AndrewWash/Ottopot_buttons/ottopotSC/assets/0.9-ottopot-glamour.jpeg

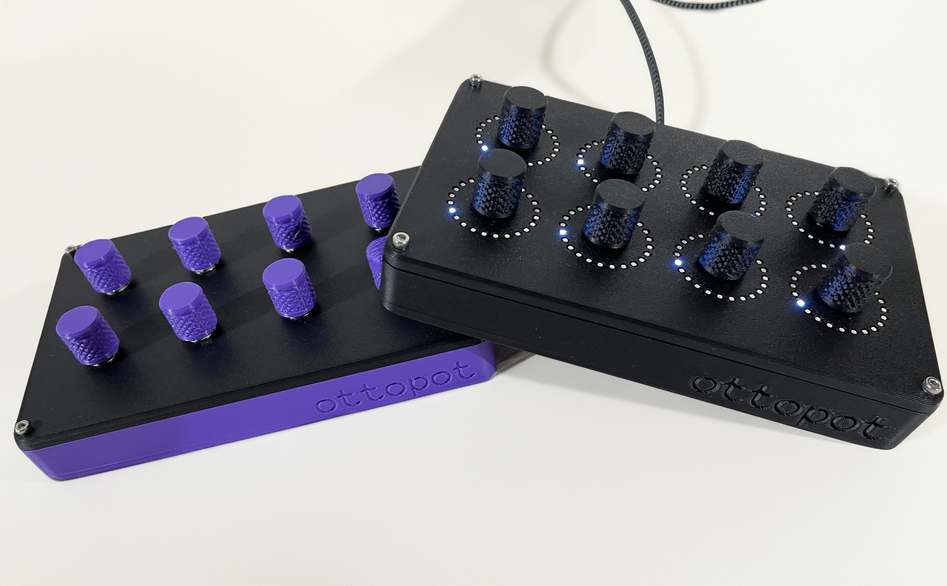
ottopotSC/assets/0.9-ottopot-glamour.jpeg
