AndrewWash/Ottopot_buttons/ottopotSC/assets/ottopot-glamour.jpeg

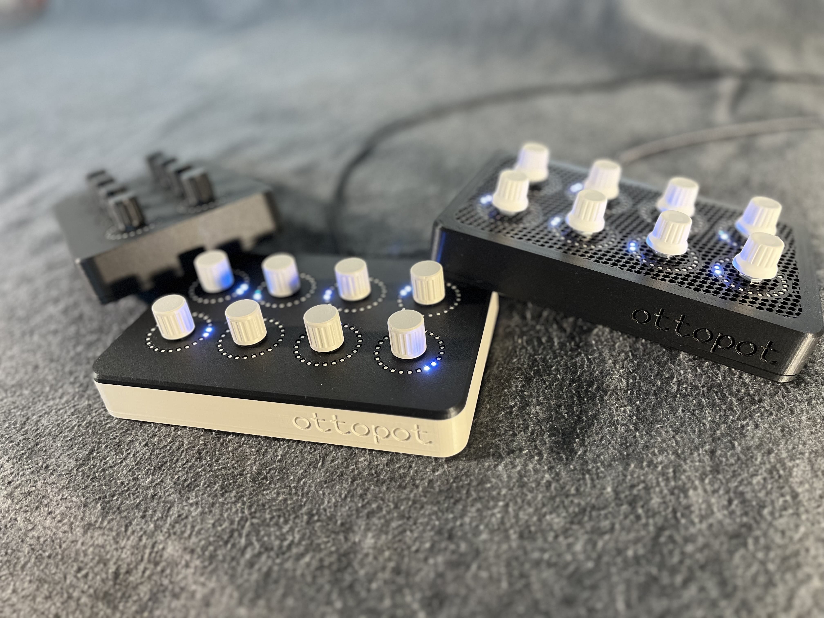
ottopotSC/assets/ottopot-glamour.jpeg
