AndrewWash/Ottopot_buttons/(list of files, cad)

Other CAD files:
ottopotSC/3D Models/Ottopot_v5-Knob.blend
ottopotSC/3D Models/Ottopot_v5.blend
zArchive/ottopotSC/3D Models/Ottopot_v5-Knob.blend
zArchive/ottopotSC/3D Models/Ottopot_v5.blend
