AndrewWash/Ottopot_buttons/ottopotSC/kicad/Ottopot.kicad_pcb

## KiCad design zArchive/ottopotSC/kicad/Ottopot.kicad_pcb (2026-05-15, an earlier design)

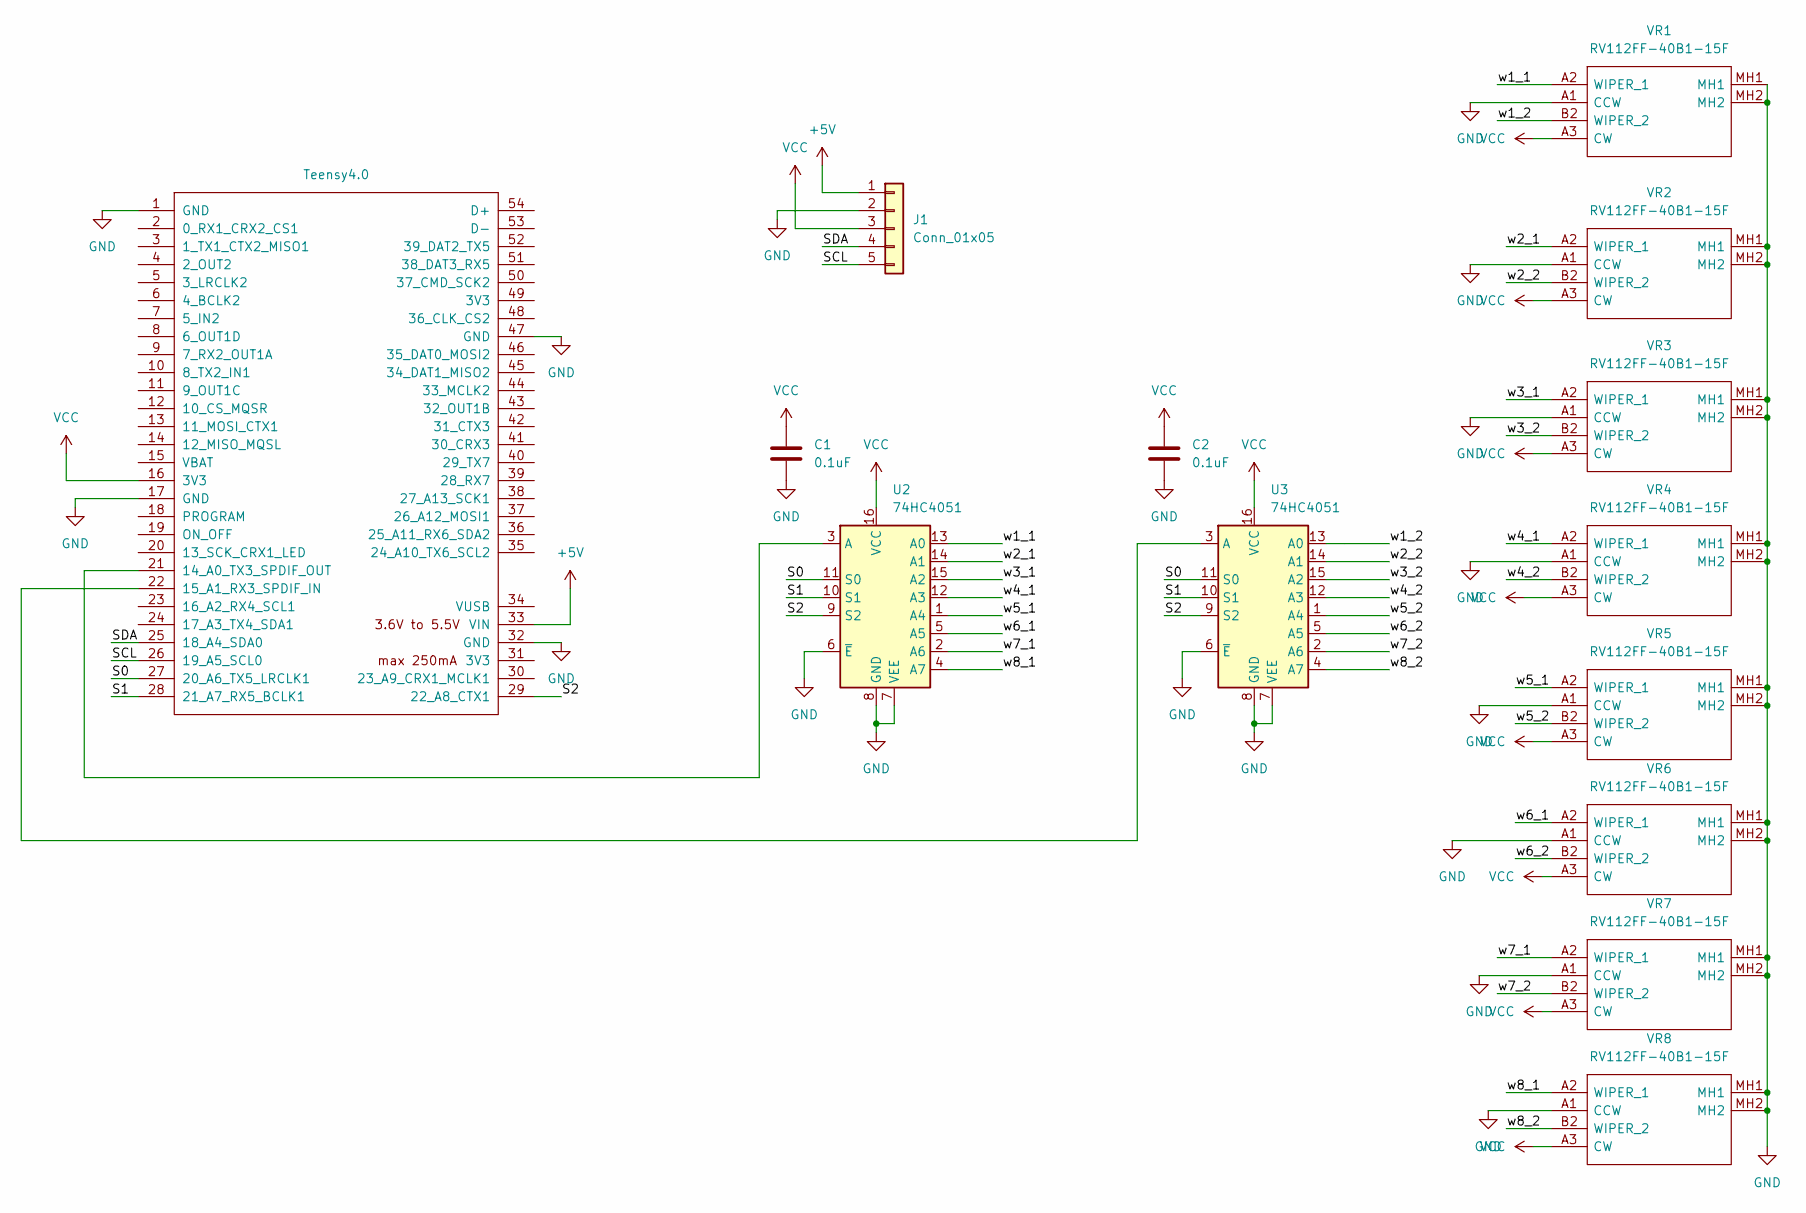
[picture p3: schematic Ottopot.kicad_sch]

Parts:
C1, C2: 0.1uF; C_Disc_D3.0mm_W1.6mm_P2.50mm
J1: Conn_01x05; Molex_PicoBlade_53048-0510_1x05_P1.25mm_Horizontal
U1: Teensy4.0; Teensy40
U2, U3: 74HC4051; DIP-16_W7.62mm
VR1, VR2, VR3, VR4, VR5, VR6, VR7, VR8: RV112FF-40B1-15F; RV112FF40B115F; Manufacturer_Part_Number RV112FF-40B1-15F

Connections:
+5V: J1.1, U1.33 (VIN)
/S0: U1.27 (20_A6_TX5_LRCLK1), U2.11 (S0), U3.11 (S0)
/S1: U1.28 (21_A7_RX5_BCLK1), U2.10 (S1), U3.10 (S1)
/S2: U1.29 (22_A8_CTX1), U2.9 (S2), U3.9 (S2)
/SCL: J1.5, U1.26 (19_A5_SCL0)
/SDA: J1.4, U1.25 (18_A4_SDA0)
/w1_1: U2.13 (A0), VR1.A2 (WIPER_1)
/w1_2: U3.13 (A0), VR1.B2 (WIPER_2)
/w2_1: U2.14 (A1), VR2.A2 (WIPER_1)
/w2_2: U3.14 (A1), VR2.B2 (WIPER_2)
/w3_1: U2.15 (A2), VR3.A2 (WIPER_1)
/w3_2: U3.15 (A2), VR3.B2 (WIPER_2)
/w4_1: U2.12 (A3), VR4.A2 (WIPER_1)
/w4_2: U3.12 (A3), VR4.B2 (WIPER_2)
/w5_1: U2.1 (A4), VR5.A2 (WIPER_1)
/w5_2: U3.1 (A4), VR5.B2 (WIPER_2)
/w6_1: U2.5 (A5), VR6.A2 (WIPER_1)
/w6_2: U3.5 (A5), VR6.B2 (WIPER_2)
/w7_1: U2.2 (A6), VR7.A2 (WIPER_1)
/w7_2: U3.2 (A6), VR7.B2 (WIPER_2)
/w8_1: U2.4 (A7), VR8.A2 (WIPER_1)
/w8_2: U3.4 (A7), VR8.B2 (WIPER_2)
GND: C1.2, C2.2, J1.2, U1.1 (GND), U1.17 (GND), U1.32 (GND), U1.47 (GND), U2.6 (~E), U2.7 (VEE), U2.8 (GND), U3.6 (~E), U3.7 (VEE), U3.8 (GND), VR1.A1 (CCW), VR1.MH1, VR1.MH2, VR2.A1 (CCW), VR2.MH1, VR2.MH2, VR3.A1 (CCW), VR3.MH1, VR3.MH2, VR4.A1 (CCW), VR4.MH1, VR4.MH2, VR5.A1 (CCW), VR5.MH1, VR5.MH2, VR6.A1 (CCW), VR6.MH1, VR6.MH2, VR7.A1 (CCW), VR7.MH1, VR7.MH2, VR8.A1 (CCW), VR8.MH1, VR8.MH2
unnamed: U1.21 (14_A0_TX3_SPDIF_OUT), U2.3 (A)
unnamed: U1.22 (15_A1_RX3_SPDIF_IN), U3.3 (A)
VCC: C1.1, C2.1, J1.3, U1.16 (3V3), U2.16 (VCC), U3.16 (VCC), VR1.A3 (CW), VR2.A3 (CW), VR3.A3 (CW), VR4.A3 (CW), VR5.A3 (CW), VR6.A3 (CW), VR7.A3 (CW), VR8.A3 (CW)

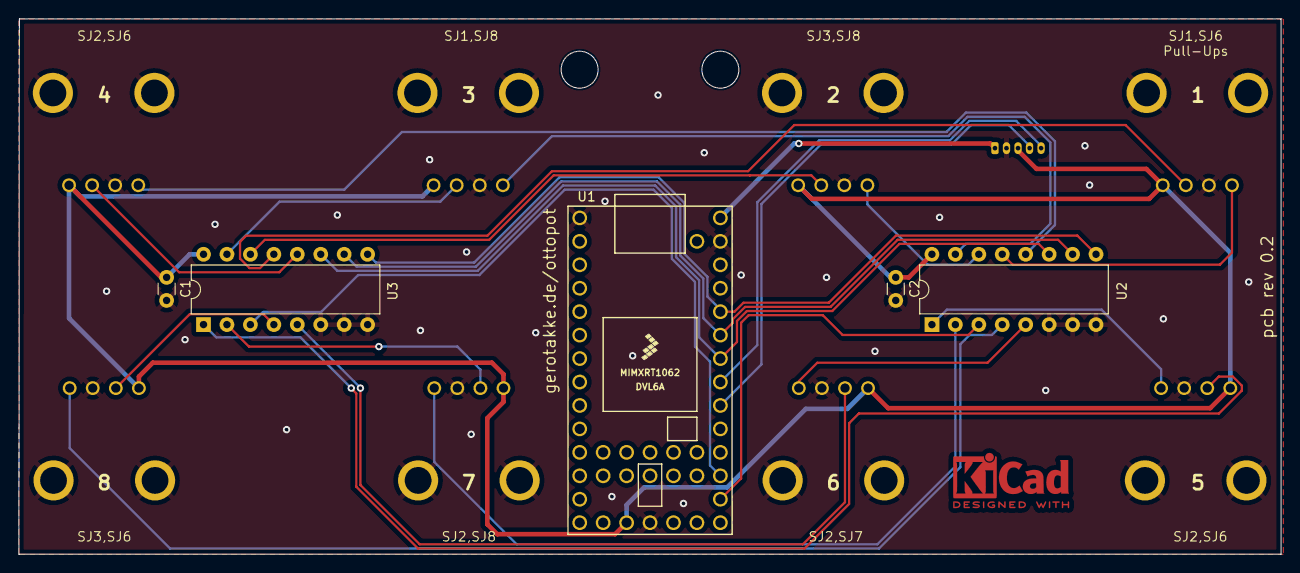
[picture p4: board Ottopot.kicad_pcb from above]

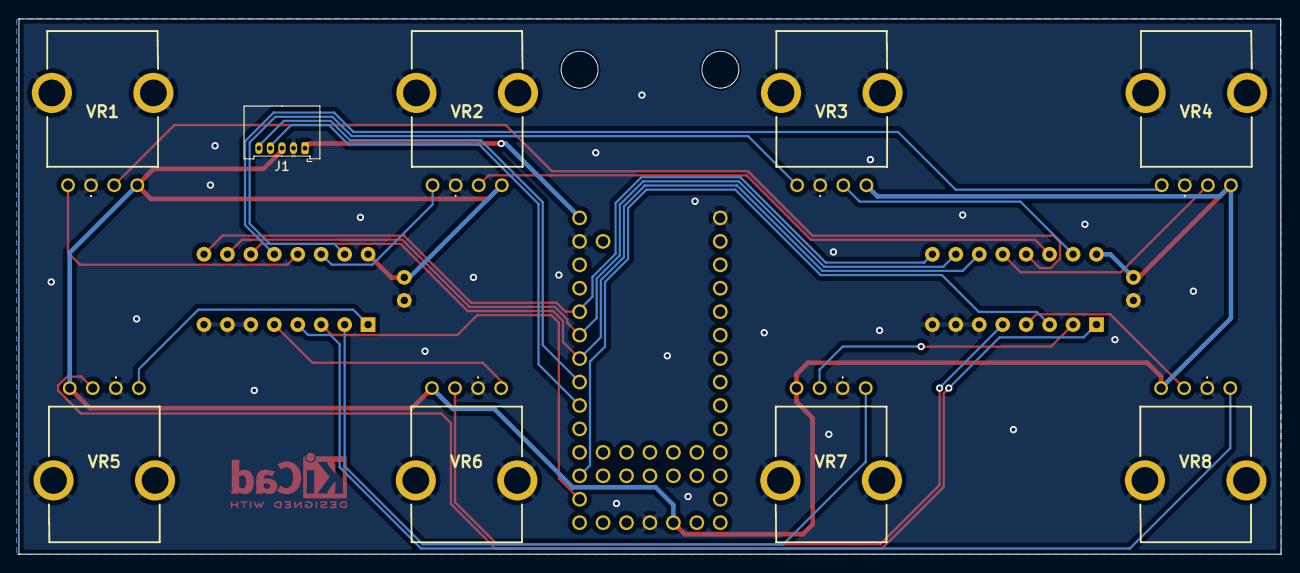
[picture p5: board Ottopot.kicad_pcb from below]

Board: 2 copper layers, 136.8 x 58.0 mm, 14 parts (9 on the bottom side), 26 nets.
