AndrewWash/Ottopot_buttons/(commit log)

2026-05-15 Initial commit - Worked off of github initially. Should be pretty close but need to wire it up and compile firmware to test
    [Ottopot.kicad_pcb, Ottopot.kicad_sch, Ottopot_v5-Knob.blend, Ottopot_v5.blend]
2026-05-16 prelim fixes. Seems to fix the "resume from last knob postiton" issue as well!
    [Ottopot.kicad_pcb, Ottopot.kicad_sch, Ottopot_v5-Knob.blend, Ottopot_v5.blend]
2026-05-16 first attempt at fixing the lagout at slow speeds. seems a bit better...
    [OttoPot.cpp, OttoPot.h, ottopot_wash_buttons_SC.ino]
2026-05-16 New method prelim build. seems to be better with the random value throwing, maybe tweak more. backup just in case
