AndrewWash/Ottopot_buttons/(notices)

Notices in the files:
zArchive/ottopotSC/kicad/Ottopot.kicad_pcb:
License: CC BY 4.0
